quyen-ong/Temporary-Immersion-Bioreactor/README.md

# Temporary Immersion Bioreactor

**Bioreactor circuitry and code instructions**: [Google Docs link](https://docs.google.com/document/d/1eFGHNYcCwDcwbPrd09a7AQx_5VXZiTRYb7Jq9ZDGCpA/edit?usp=sharing)

**Photos and Videos**: [Google Photos link](https://photos.app.goo.gl/6ngy7DwCwPjk1CvY6)
