quyen-ong/Temporary-Immersion-Bioreactor/SolidWorks Files/Bioreactor Dome.SLDPRT

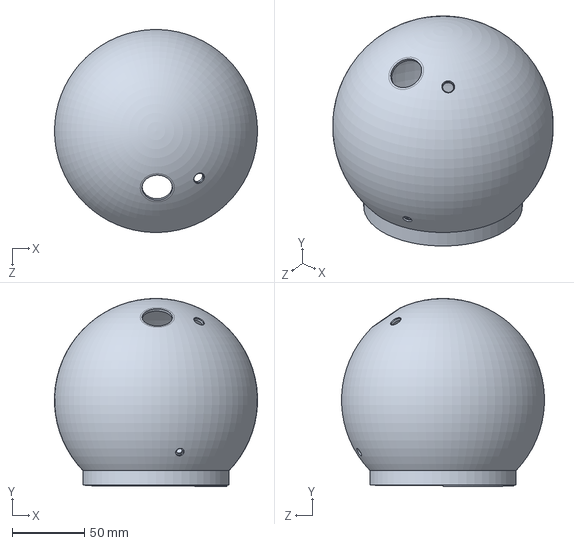
[picture p13: CAD file, 2024-11-25]
SolidWorks Files/Bioreactor Dome.SLDPRT
140.3 x 130.0 x 140.2 mm
