quyen-ong/Temporary-Immersion-Bioreactor/SolidWorks Files/Bioreactor Cone.SLDPRT

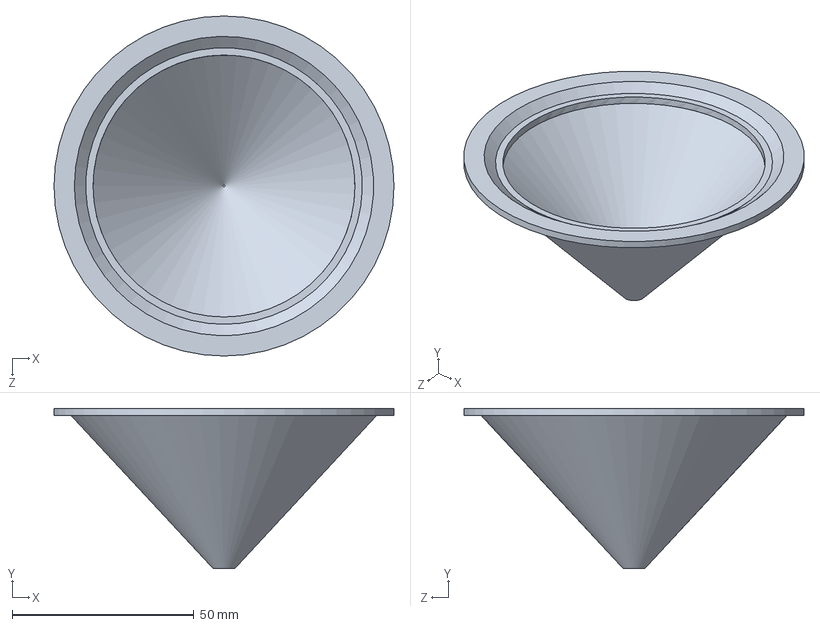
[picture p14: CAD file, 2024-11-25]
SolidWorks Files/Bioreactor Cone.SLDPRT
93.5 x 44.0 x 93.5 mm
