quyen-ong/Temporary-Immersion-Bioreactor/SolidWorks Files/Bioreactor Propogation Framing.SLDPRT

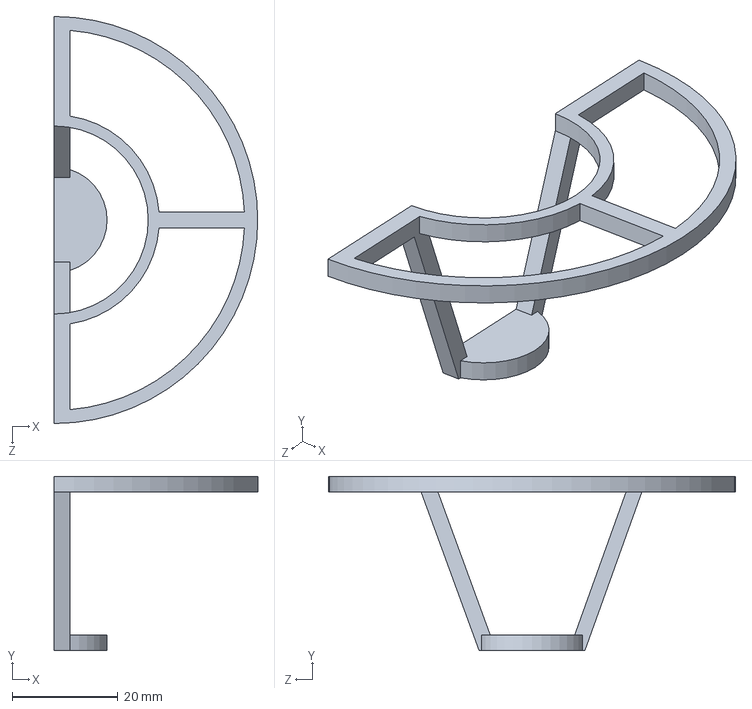
[picture p15: CAD file, 2024-11-25]
SolidWorks Files/Bioreactor Propogation Framing.SLDPRT
38.5 x 33.0 x 77.0 mm
