quyen-ong/Temporary-Immersion-Bioreactor/SolidWorks Files/Bioreactor Reservoir.SLDPRT

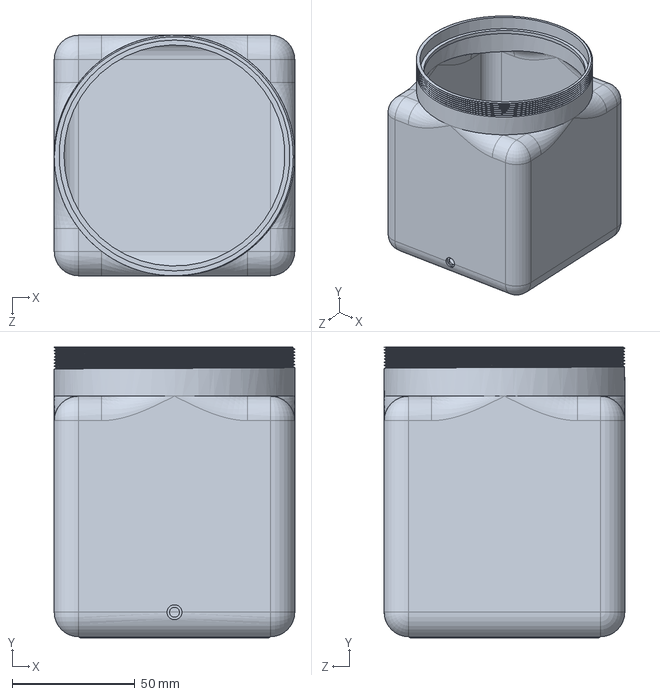
[picture p16: CAD file, 2024-11-25]
SolidWorks Files/Bioreactor Reservoir.SLDPRT
98.0 x 118.5 x 98.0 mm
