quyen-ong/Temporary-Immersion-Bioreactor/Test Code/README.md

This folder contains the code to individually test the CO2 sensor, pump, and temperature sensor.
