quyen-ong/Temporary-Immersion-Bioreactor/(commit log)

2024-11-13 added arduino code for the bioreactor
2024-11-25 added CDR and SolidWorks files
    [Bioreactor Cone.SLDPRT, Bioreactor Dome.SLDPRT, Bioreactor Propogation Framing.SLDPRT, Bioreactor Reservoir.SLDPRT]
